Uhome-systems/Uhome/README.md

- 👋 Hi, I’m @Uhome-Systems
- 🌐 Our website is https://uhome.systems/
- 👀 I’m interested in smart home systems
- 📫 How to reach me info@uhome.systems
- 💬 Join our Discord here: https://discord.gg/JBZaJAvD
