Uhome-systems/Uhome/Software/README.md

Latest firmware V2.24 based on nRF Connect SDK 2.6.0
Previous firmware V1.2 based on nRF SDK for Thread and Zigbee
