Uhome-systems/Uhome/Software/nRF_Connect_SDK_2.6.0/TWV_nRF_Connect_SDK_project/boards/arm/twv_pcb_0_6/doc/index.rst

.. _twv_pcb_0_6:

TWV PCB
###########

Overview
********

* :abbr:`ADC (Analog to Digital Converter)`
* CLOCK
* FLASH
* :abbr:`GPIO (General Purpose Input Output)`
* :abbr:`I2C (Inter-Integrated Circuit)`
* :abbr:`MPU (Memory Protection Unit)`
* :abbr:`NVIC (Nested Vectored Interrupt Controller)`
* :abbr:`PWM (Pulse Width Modulation)`
* RADIO (Bluetooth Low Energy and 802.15.4)
* :abbr:`RTC (nRF RTC System Clock)`
* Segger RTT (RTT Console)
* :abbr:`SPI (Serial Peripheral Interface)`
* :abbr:`UART (Universal asynchronous receiver-transmitter)`
* :abbr:`USB (Universal Serial Bus)`
* :abbr:`WDT (Watchdog Timer)`

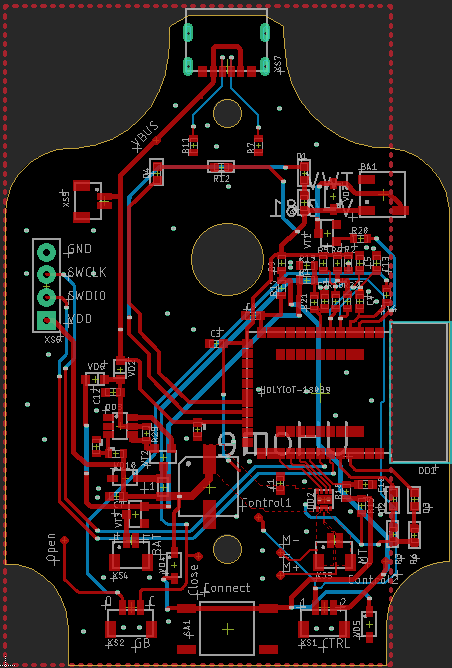
[picture p1: Software/nRF_Connect_SDK_2.6.0/TWV_nRF_Connect_SDK_project/boards/arm/twv_pcb_0_6/doc/twv_pcb_0_6.png]
TWV
