Uhome-systems/Uhome/Hardware/Step-files/TWV.step

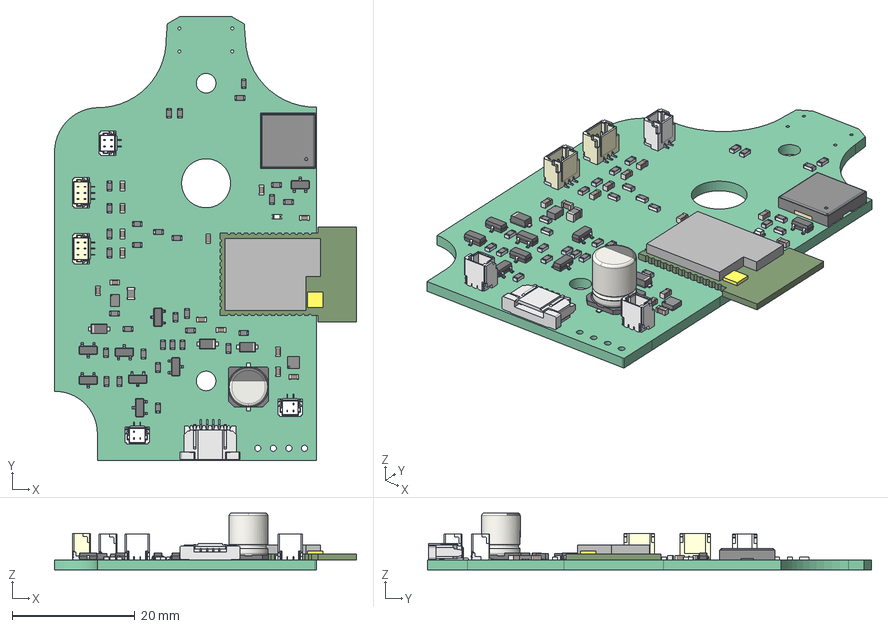
[picture p2: CAD file, 2024-04-14]
Hardware/Step-files/TWV.step
49.3 x 72.5 x 9.30 mm
Local_CS_2f15
Pcb_2f15
PCB_Sketch_2f15
RC0603JR-070RL x 31
RC0603JR-070RL001 x 31
RC0603JR-070RL002 x 31
RC0603JR-070RL003 x 31
${REFERENCE}_SOT_23_null x 8
${REFERENCE}_C_0603_1608Metric_null x 14
${REFERENCE}_CP_Elec_63x77_null
${REFERENCE}_D_SOD_123F_null x 3
${REFERENCE}_L_0805_2012Metric_null
Board
Extruded
Extruded001
Extruded002
BMxxB-SRSS-TB(LF)(SN)_02 x 3
BMxxB-SRSS-TB(LF)(SN)_003 x 3
BMxxB-SRSS-TB(LF)(SN)_004 x 3
BMxxB-SRSS-TB(LF)(SN)_005 x 3
BMxxB-SRSS-TB(LF)(SN)_006 x 3
BMxxB-SRSS-TB(LF)(SN)_007 x 3
BMxxB-SRSS-TB(LF)(SN)_008 x 3
BMxxB-SRSS-TB(LF)(SN)_009 x 3
BMxxB-SRSS-TB(LF)(SN)_010 x 3
PKMCS0909E4000-R1
PKMCS0909E4000-R002
PKMCS0909E4000-R003
DLC8
DLC009
DLC010
DLC011
DLC012
DLC013
DLC014
DLC015
DLC016
DLC017
BM03B-SRSS-TB(LF)(SN) x 2
BM03B-SRSS-TB(LF)(SN)001 x 2
BM03B-SRSS-TB(LF)(SN)002 x 2
BM03B-SRSS-TB(LF)(SN)003 x 2
BM03B-SRSS-TB(LF)(SN)004 x 2
BM03B-SRSS-TB(LF)(SN)005 x 2
BM03B-SRSS-TB(LF)(SN)006 x 2
BM03B-SRSS-TB(LF)(SN)007 x 2
BM03B-SRSS-TB(LF)(SN)008 x 2
BM03B-SRSS-TB(LF)(SN)009 x 2
BM03B-SRSS-TB(LF)(SN)010 x 2
BM03B-SRSS-TB(LF)(SN)011 x 2
XS8_SFW_R-2ST_LF_null
TPS62173DSGR
TPS62173DSGR001
TPS62173DSGR002
TPS62173DSGR003
TPS62173DSGR004
TPS62173DSGR005
TPS62173DSGR006
TPS62173DSGR007
TPS62173DSGR008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
