Uhome-systems/Uhome/Hardware/ChangeLog.txt

TWV PCB V0.81
1. Transferring all components to the TOP layer.
2. Ned DC-DC TPS64201DBVR with lower power consumption.
