Uhome-systems/Uhome/Hardware/Schematic/TWV.pdf

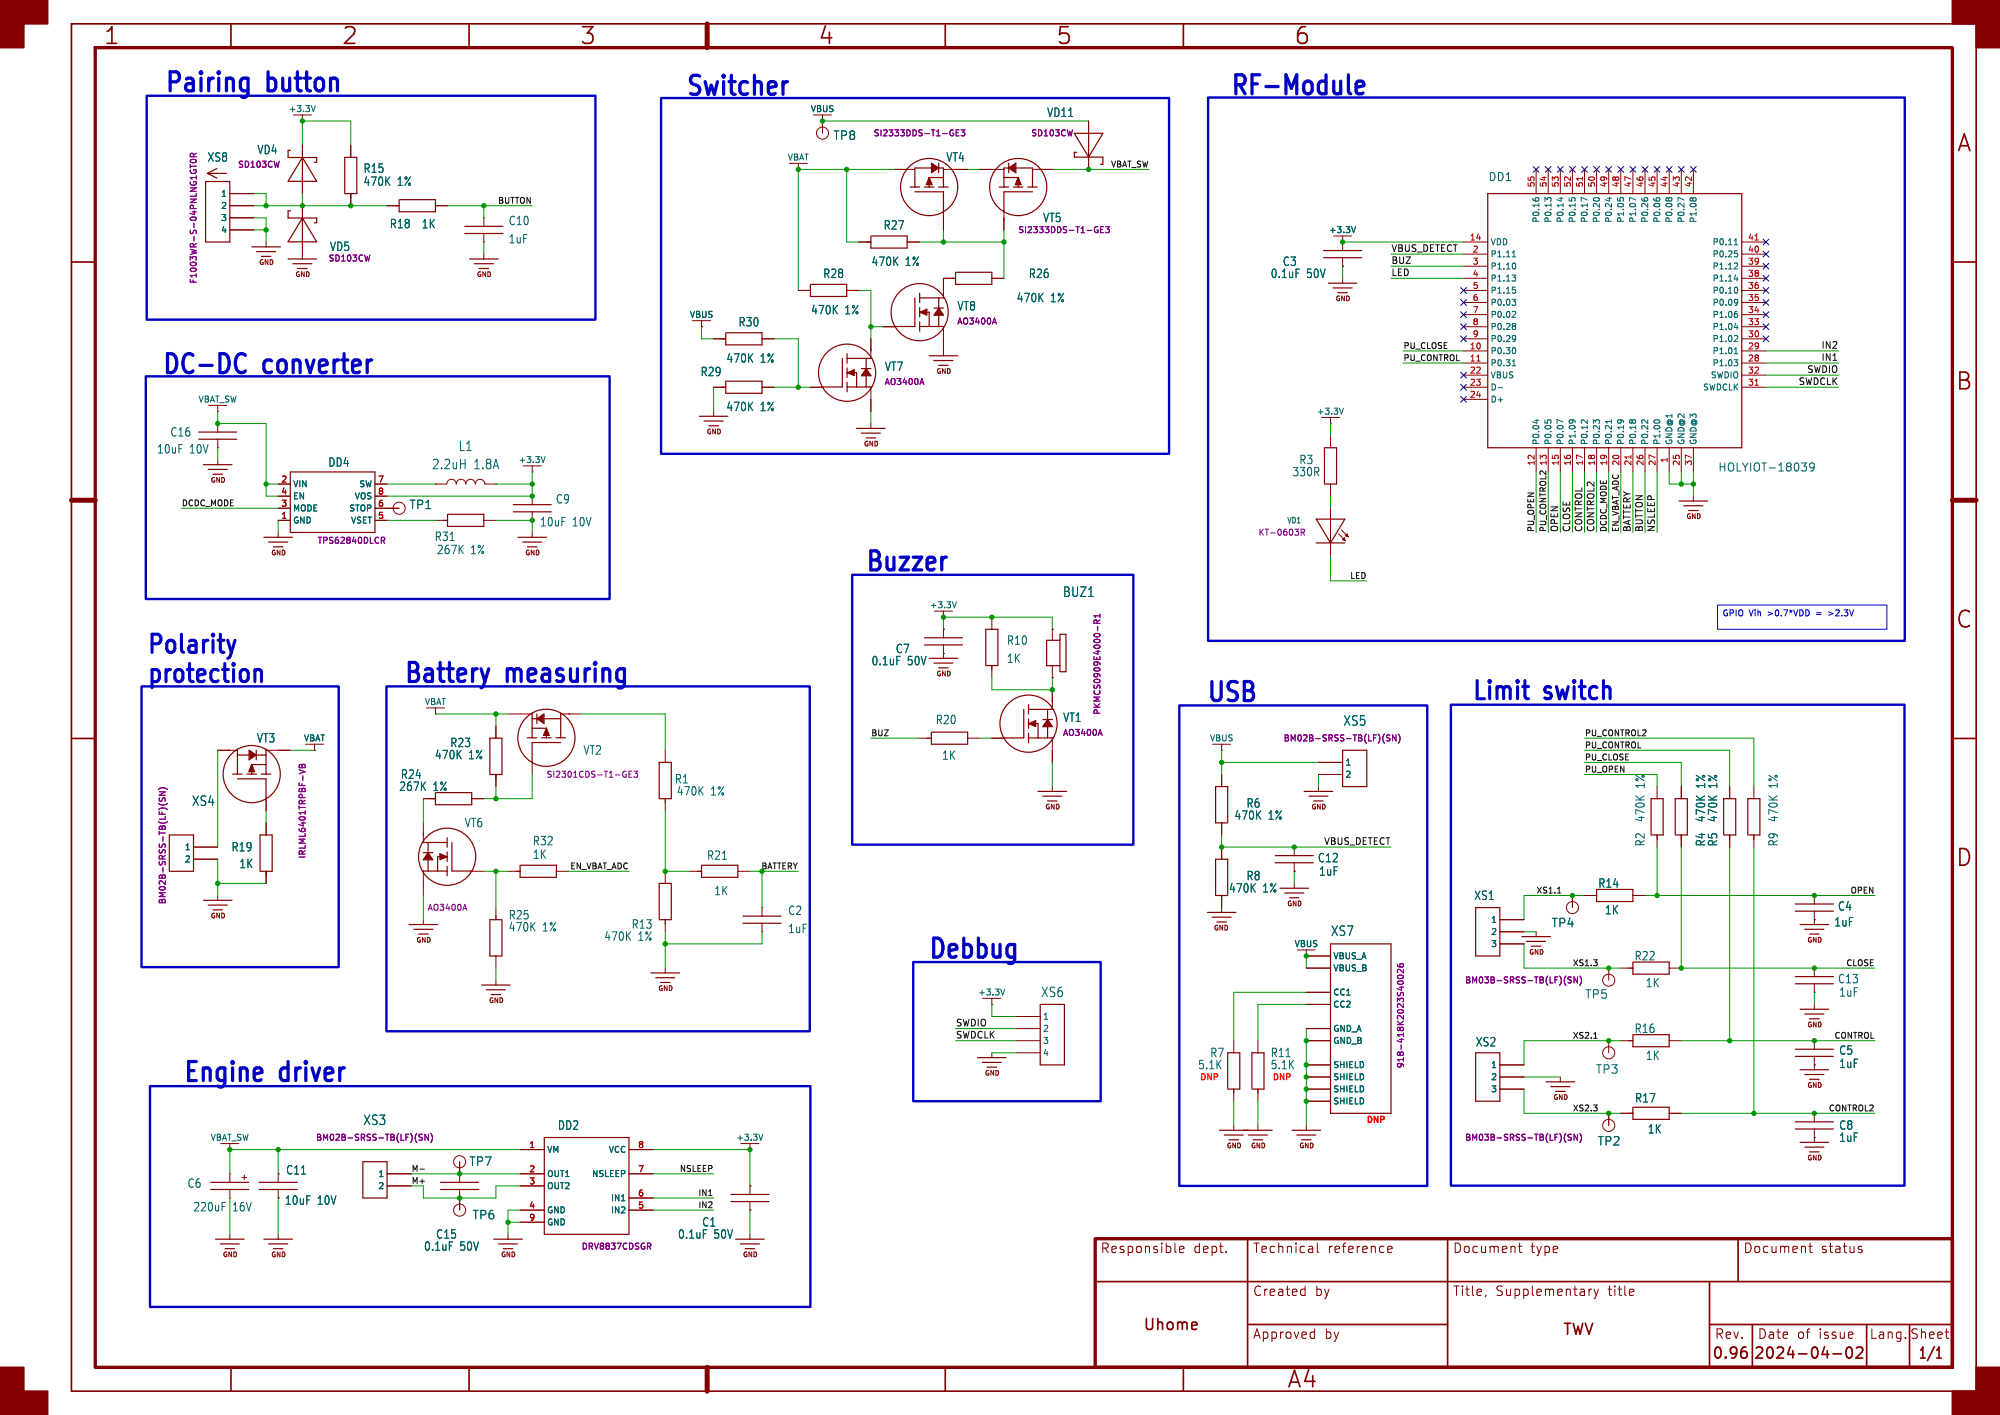
[picture p3: page 1]

BM02B-SRSS-TB(LF)(SN) GND C6

BM03B-SRSS-TB(LF)(SN) VBAT R24

BM02B-SRSS-TB(LF)(SN) 1

BM03B-SRSS-TB(LF)(SN) 1

BM03B-SRSS-TB(LF)(SN)
