Uhome-systems/Uhome/Hardware/Source-files/TWV.kicad_pcb

## KiCad design Hardware/Source-files/TWV.kicad_pcb (2024-04-14)

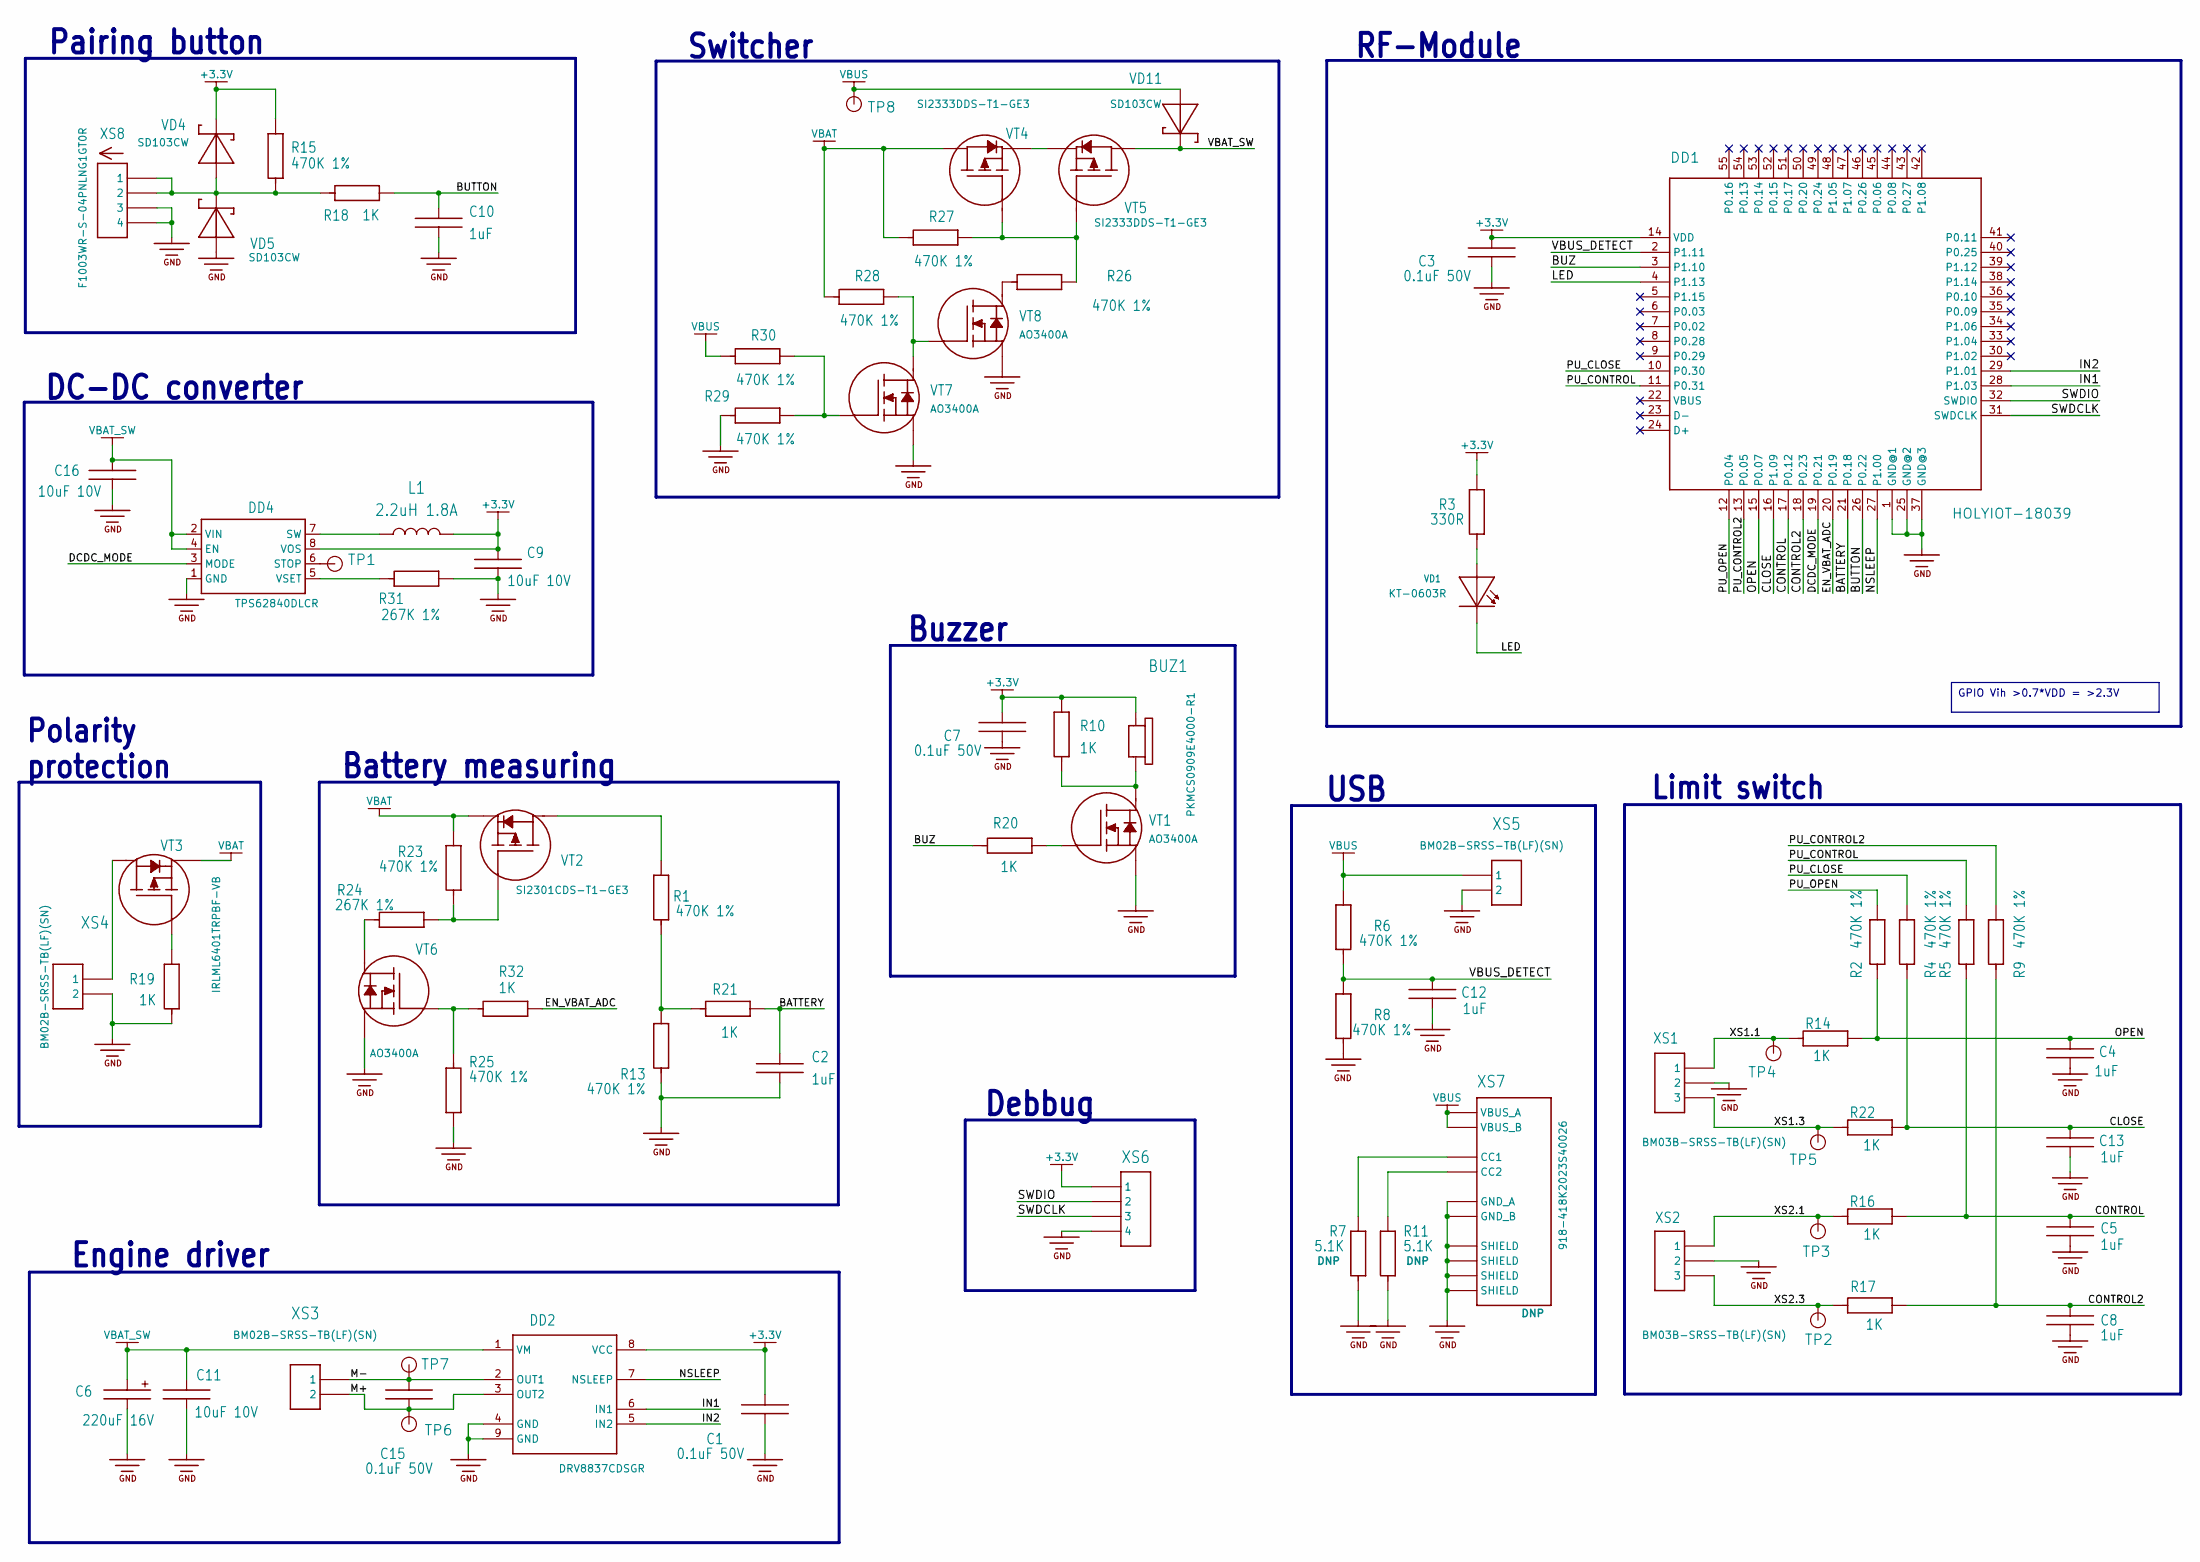
[picture p4: schematic TWV.kicad_sch]

Parts:
BUZ1: PKMCS0909E4000-R1; Manufacturer PN PKMCS0909E4000-R1; JLCPCB PN C910763
C1, C3, C7, C15: 0.1uF 50V; C_0603_1608Metric; Manufacturer PN CC0603KRX7R9BB104; JLCPCB PN C14663
C2, C4, C5, C8, C10, C12, C13: 1uF; C_0603_1608Metric; Manufacturer PN CL10A105KB8NNNC; JLCPCB PN C15849
C6: 220uF 16V; CP_Elec_6.3x7.7; Manufacturer PN VT220UF16V167RV0088; JLCPCB PN C5246575
C9, C11, C16: 10uF 10V; C_0603_1608Metric; Manufacturer PN CL10A106KP8NNNC; JLCPCB PN C19702
DD1: HOLYIOT-18039
DD2: WSON-8; Manufacturer PN DRV8837CDSGR; JLCPCB PN C191000
DD4: VSON-8; Manufacturer PN TPS62840DLCR; JLCPCB PN C2071859
L1: 2.2uH 1.8A; L_0805_2012Metric; Manufacturer PN DFE201612E-2R2M=P2; JLCPCB PN C337893
R1, R2, R4, R5, R6, R8, R9, R13, R15, R23, R25, R26, R27, R28, R29, R30: 470K 1%; R_0603_1608Metric; Manufacturer PN 0603WAF4703T5E; JLCPCB PN C23178
R3: 330R; R_0603_1608Metric; Manufacturer PN 0603WAF3300T5E; JLCPCB PN C23138
R7, R11: 5.1K; R_0603_1608Metric; Manufacturer PN 0603WAF5101T5E; JLCPCB PN C23186
R10, R14, R16, R17, R18, R19, R20, R21, R22, R32: 1K; R_0603_1608Metric; Manufacturer PN 0603WAF1001T5E; JLCPCB PN C21190
R24, R31: 267K 1%; R_0603_1608Metric; Manufacturer PN 0603WAF2673T5E; JLCPCB PN C22963
TP1, TP2, TP3, TP4, TP5, TP6, TP7, TP8: TEST_POINT_2MM
VD1: LED_0603; Manufacturer PN KT-0603R; JLCPCB PN C2286
VD4, VD5: SD103CW-AQ; D_SOD-123F; Manufacturer PN SD103CW; JLCPCB PN C21572
VD11: D_SOD-123F; Manufacturer PN SD103CW; JLCPCB PN C21572
VT1, VT6, VT7, VT8: Q_SOT-23; Manufacturer PN AO3400A; JLCPCB PN C20917
VT2: P-type; Q_SOT-23; Manufacturer PN SI2301CDS-T1-GE3; JLCPCB PN C10487
VT3: Q_SOT-23; Manufacturer PN IRLML6401TRPBF-VB; JLCPCB PN C558179
VT4, VT5: Q_SOT-23; Manufacturer PN SI2333DDS-T1-GE3; JLCPCB PN C183004
XS1, XS2: BM03B-SRSS-TB; Manufacturer PN BM03B-SRSS-TB(LF)(SN); JLCPCB PN C160389
XS3, XS5: BM02B-SRSS-TB; Manufacturer PN BM02B-SRSS-TB(LF)(SN); JLCPCB PN C160388
XS4: BM02B-SRSS-TB; Manufacturer PN BM02B-SRSS-TB(LF)(SN); JLCPCB PN C160388
XS6: TH1X4-2.54MM
XS7: 918-418K2023S40026; Manufacturer PN 918-418K2023S40026; JLCPCB PN C2763104
XS8: F1003WR-S-04PNLNG1GT0R; Manufacturer PN F1003WR-S-04PNLNG1GT0R; JLCPCB PN C247801

Connections:
+3.3V: BUZ1.1 (+), C1.1, C3.1, C7.1, C9.1, DD1.14 (VDD), DD2.8 (VCC), DD4.8 (VOS), L1.2, R3.2, R10.2, R15.2, VD4.C, XS6.1
/BATTERY: C2.1, DD1.21 (P0.18), R21.2
/BUTTON: C10.1, DD1.26 (P0.22), R18.2
/BUZ: DD1.3 (P1.10), R20.1
/CLOSE: C13.1, DD1.16 (P1.09), R4.1, R22.2
/CONTROL: C5.1, DD1.17 (P0.12), R5.1, R16.2
/CONTROL2: C8.1, DD1.18 (P0.23), R9.1, R17.2
/DCDC_MODE: DD1.19 (P0.21), DD4.3 (MODE)
/EN_VBAT_ADC: DD1.20 (P0.19), R32.2
/IN1: DD1.28 (P1.03), DD2.6 (IN1)
/IN2: DD1.29 (P1.01), DD2.5 (IN2)
/LED: DD1.4 (P1.13), VD1.1 (C)
/M+: C15.2, DD2.3 (OUT2), TP6.1, XS3.2
/M-: C15.1, DD2.2 (OUT1), TP7.1, XS3.1
/NSLEEP: DD1.27 (P1.00), DD2.7 (NSLEEP)
/OPEN: C4.1, DD1.15 (P0.07), R2.1, R14.2
/PU_CLOSE: DD1.10 (P0.30), R4.2
/PU_CONTROL: DD1.11 (P0.31), R5.2
/PU_CONTROL2: DD1.13 (P0.05), R9.2
/PU_OPEN: DD1.12 (P0.04), R2.2
/SWDCLK: DD1.31 (SWDCLK), XS6.3
/SWDIO: DD1.32 (SWDIO), XS6.2
/VBUS_DETECT: C12.1, DD1.2 (P1.11), R6.1, R8.2
/XS1.1: R14.1, TP4.1, XS1.1
/XS1.3: R22.1, TP5.1, XS1.3
/XS2.1: R16.1, TP3.1, XS2.1
/XS2.3: R17.1, TP2.1, XS2.3
GND: C1.2, C2.2, C3.2, C4.2, C5.2, C6.2 (-), C7.2, C8.2, C9.2, C10.2, C11.2, C12.2, C13.2, C16.2, DD1.1 (GND@1), DD1.25 (GND@2), DD1.37 (GND@3), DD2.4 (GND), DD2.9 (GND), DD4.1 (GND), R7.1, R8.1, R11.1, R13.1, R19.1, R25.2, R29.1, R31.2, VD5.A, VT1.2 (S), VT6.2 (S), VT7.2 (S), VT8.2 (S), XS1.2, XS2.2, XS4.2, XS5.2, XS6.4, XS7.A12 (GND_A), XS7.B12 (GND_B), XS7.SH1 (SHIELD), XS7.SH2 (SHIELD), XS7.SH3 (SHIELD), XS7.SH4 (SHIELD), XS8.3, XS8.4
unnamed: BUZ1.2 (-), R10.1, VT1.3 (D)
unnamed: DD4.6 (STOP), TP1.1
unnamed: DD4.7 (SW), L1.1
unnamed: DD4.5 (VSET), R31.1
unnamed: R1.1, R13.2, R21.1
unnamed: R15.1, R18.1, VD4.A, VD5.C, XS8.1, XS8.2
unnamed: R3.1, VD1.2 (A)
unnamed: R20.2, VT1.1 (G)
unnamed: R1.2, VT2.3 (D)
unnamed: R23.1, R24.2, VT2.1 (G)
unnamed: VT3.3 (D), XS4.1
unnamed: R19.2, VT3.1 (G)
unnamed: R26.2, R27.2, VT4.1 (G), VT5.1 (G)
unnamed: VT4.2 (S), VT5.2 (S)
unnamed: R24.1, VT6.3 (D)
unnamed: R25.1, R32.1, VT6.1 (G)
unnamed: R28.2, VT7.3 (D), VT8.1 (G)
unnamed: R29.2, R30.2, VT7.1 (G)
unnamed: R26.1, VT8.3 (D)
unnamed: R7.2, XS7.A5 (CC1)
unnamed: R11.2, XS7.B5 (CC2)
VBAT: R23.2, R27.1, R28.1, VT2.2 (S), VT3.2 (S), VT4.3 (D)
VBAT_SW: C6.1 (+), C11.1, C16.1, DD2.1 (VM), DD4.2 (VIN), DD4.4 (EN), VD11.C, VT5.3 (D)
VBUS: R6.2, R30.1, TP8.1, VD11.A, XS5.1, XS7.A9 (VBUS_A), XS7.B9 (VBUS_B)

Notes on the sheet:
GPIO Vih >0.7*VDD = >2.3V
Battery measuring
Pairing button
Debbug
Switcher
Engine driver
USB
Limit switch
Buzzer
Polarity protection
RF-Module
DC-DC converter

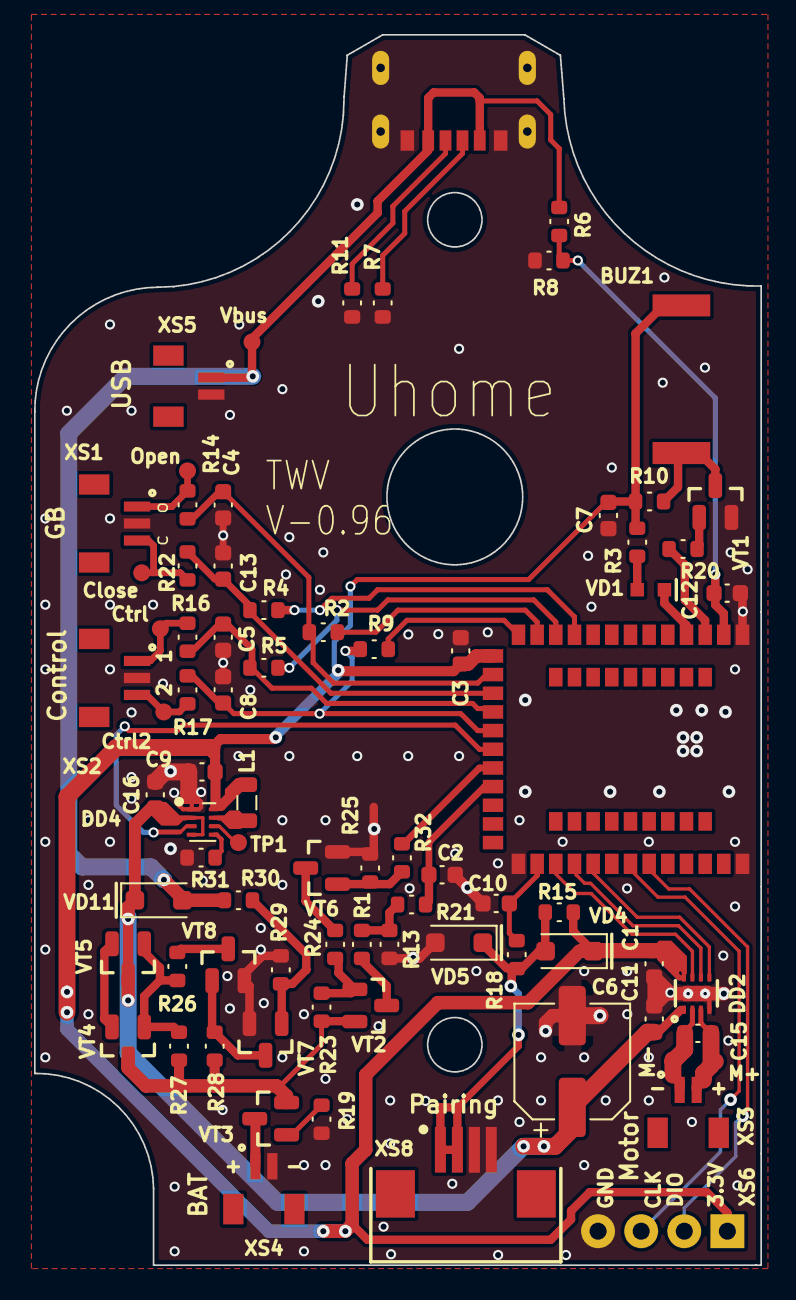
[picture p5: board TWV.kicad_pcb from above]

Board: 2 copper layers, 42.8 x 72.5 mm, 79 parts (0 on the bottom side), 52 nets.
