Uhome-systems/Uhome/(commit log)

2023-11-08 Add files via upload
    Initial commit
    [TWV_top_bom.csv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]
2023-11-09 Schematic update
2023-11-10 Hardware source files
    [TWV.brd, TWV.sch]
2023-11-13 Add parts in stl format
2024-01-24 Stable PCB version
    [JLCPCB_TWV_BOM_0.81v.csv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]
2024-04-14 update PCB to V0.96
    PCB development moved from Eagle to KiCAD.
    [BOM_TWV.csv, JLCPCB_TWV_BOM_0.81v.csv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]
